lorduy-un/Caja-compostaje-inteligente/images/caja1.jpeg

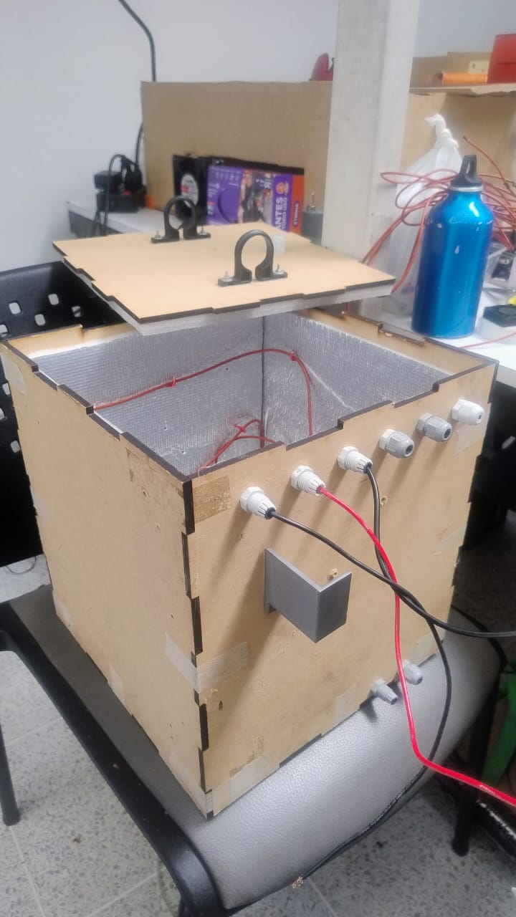
images/caja1.jpeg
