lorduy-un/Caja-compostaje-inteligente/images/Tarjeta.jpeg

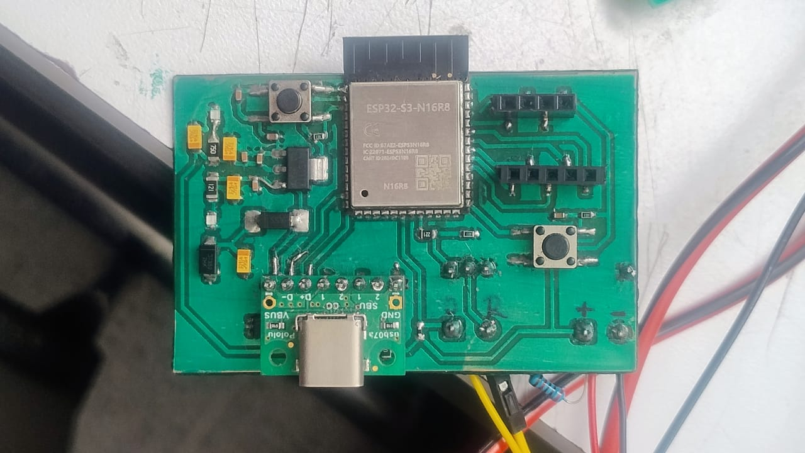
images/Tarjeta.jpeg
