lorduy-un/Caja-compostaje-inteligente/images/WhatsApp Image 2026-07-22 at 12.25.13 PM(1).jpeg

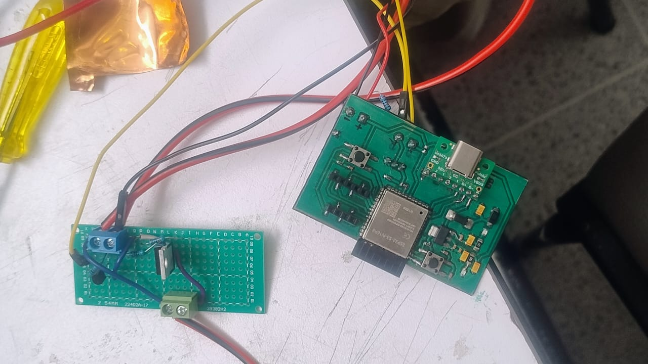
images/WhatsApp Image 2026-07-22 at 12.25.13 PM(1).jpeg
