lorduy-un/Caja-compostaje-inteligente/images/espsoldermask.jpeg

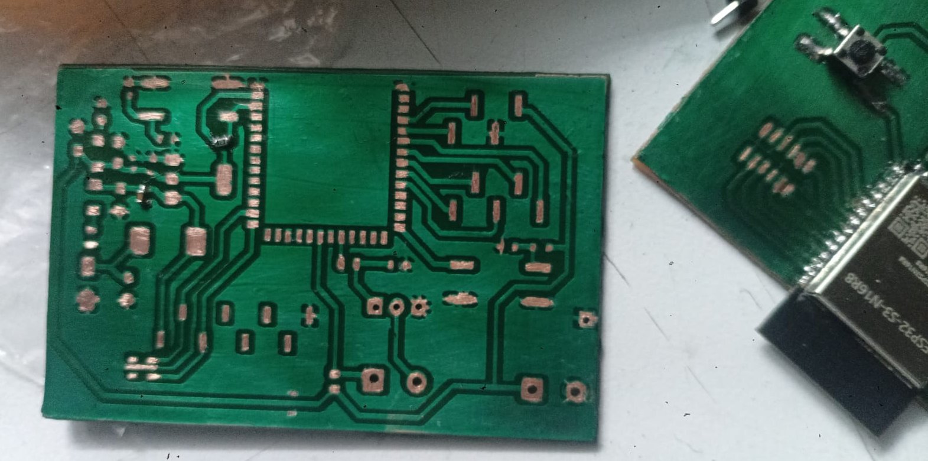
images/espsoldermask.jpeg
